hotchk155/synchole/docs/packing slip.pdf

Thank you for purchasing SYNCHOLE! I hope you find it useful and enjoy using it. For information please see http://six4pix.com/synchole
You can contact me with questions or feedback at sixtyfourpixels@gmail.com Cheers, Jason

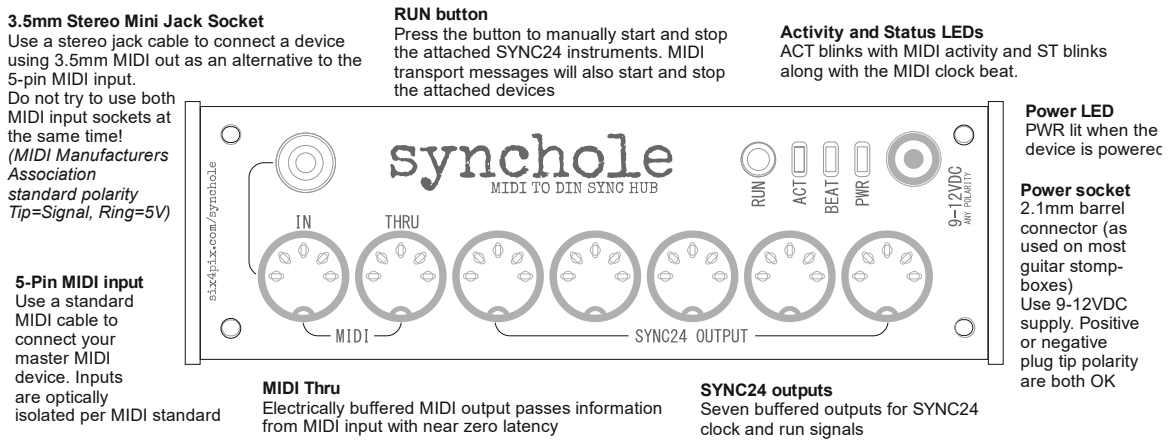
[picture p1: figure]
5-Pin MIDI input Use a standard MIDI cable to connect your master MIDI device. Inputs are optically isolated per MIDI standard; Power LED PWR lit when the device is powered; Activity and Status LEDs; along with the MIDI clock beat.; RUN button; the attached SYNC24 instruments. MIDI; the attached devices; Power socket 2.1mm barrel connector (as used on most guitar stomp- boxes) Use 9-12VDC supply. Positive or negative plug tip polarity are both OK MIDI Thru; from MIDI input with near zero latency; SYNC24 outputs Seven buffered outputs for SYNC24 clock and run signals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

ACT blinks with MIDI activity and ST blinks

Press the button to manually start and stop

transport messages will also start and stop

Electrically buffered MIDI output passes information

Use a stereo jack cable to connect a device using 3.5mm MIDI out as an alternative to the

Thank you for purchasing SYNCHOLE! I hope you find it useful and enjoy using it. For information please see http://six4pix.com/synchole
You can contact me with questions or feedback at sixtyfourpixels@gmail.com Cheers, Jason

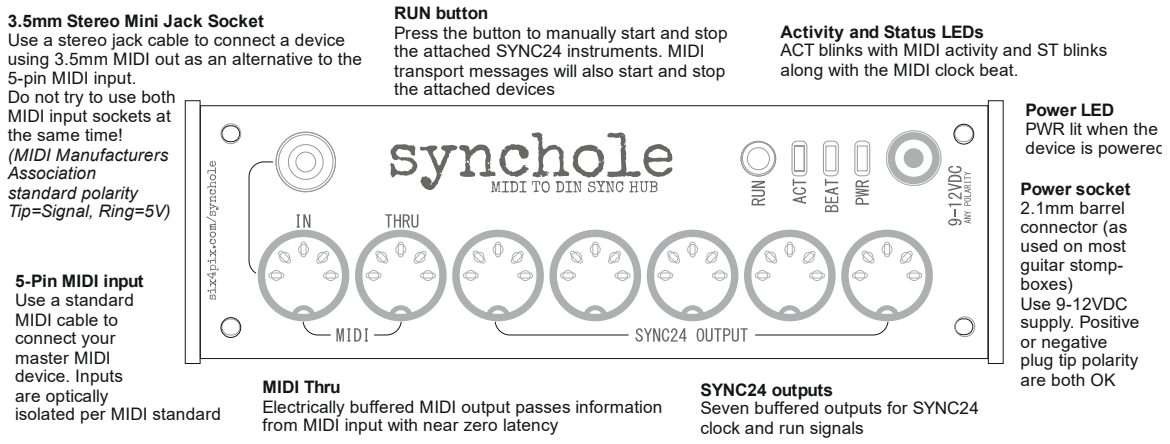
[picture p2: figure]
5-Pin MIDI input Use a standard MIDI cable to connect your master MIDI device. Inputs are optically isolated per MIDI standard; Power LED PWR lit when the device is powered; Activity and Status LEDs; along with the MIDI clock beat.; RUN button; the attached SYNC24 instruments. MIDI; the attached devices; Power socket 2.1mm barrel connector (as used on most guitar stomp- boxes) Use 9-12VDC supply. Positive or negative plug tip polarity are both OK MIDI Thru; from MIDI input with near zero latency; SYNC24 outputs Seven buffered outputs for SYNC24 clock and run signals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

ACT blinks with MIDI activity and ST blinks

Press the button to manually start and stop

transport messages will also start and stop

Electrically buffered MIDI output passes information

Use a stereo jack cable to connect a device using 3.5mm MIDI out as an alternative to the
