hotchk155/synchole/fascia/synchole-fascia-cuts.png

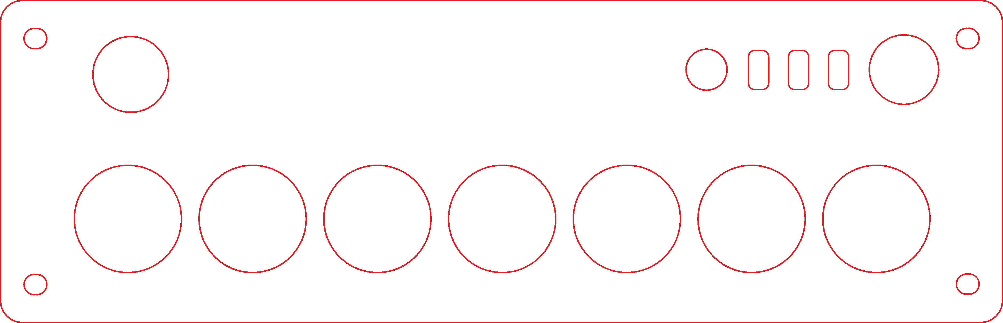
fascia/synchole-fascia-cuts.png
