hotchk155/synchole/fascia/synchole-fascia.png

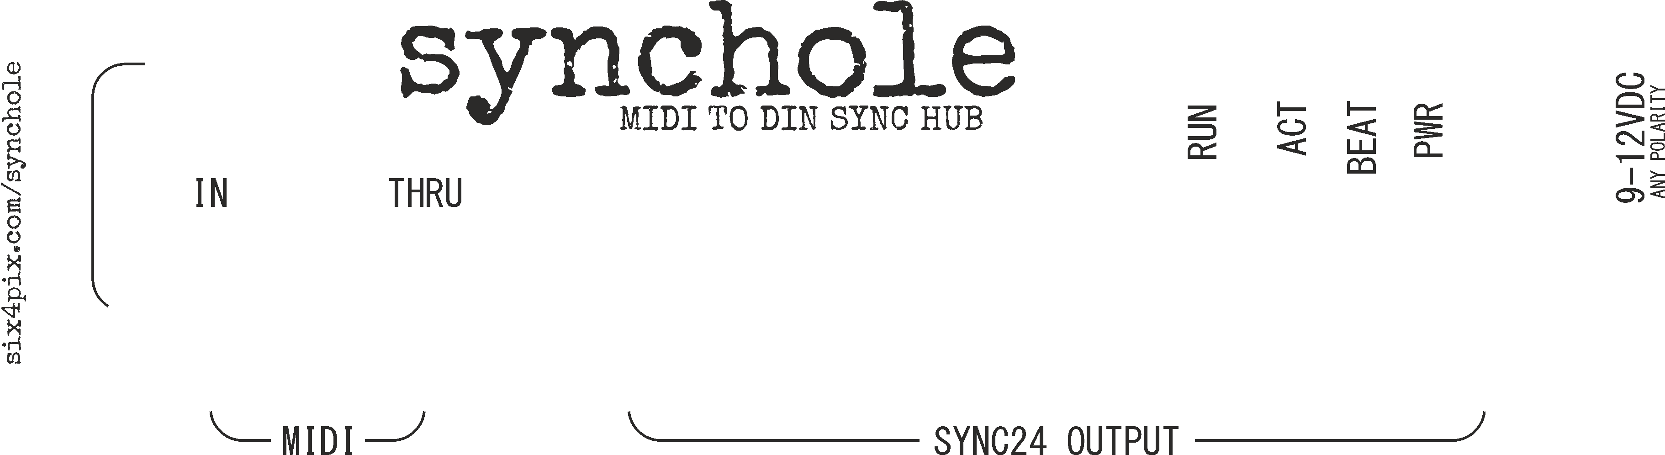
fascia/synchole-fascia.png
