hotchk155/synchole/hardware/synchole-bom.xlsx

Comment | Designator | Footprint | JLCPCB Part #（optional）
100nF | C1 | 0805
100nF | C2 | 0805
100nF | C3 | 0805
100nF | C4 | 0805
100nF | C5 | 0805
TS4148 | D1 | 0805
CD4050BD | IC1 | SO16
LD1117S50CTR | IC2 | SOT223
CD4050BD | IC3 | SO16
PIC12F1822-I/P | IC4 | SO08
1k | R1 | 0805
1k | R2 | 0805
1k | R3 | 0805
4.7k | R4 | 0805
1k | R5 | 0805
1k | R6 | 0805
1k | R7 | 0805
1k | R8 | 0805
1k | R9 | 0805
1k | R10 | 0805
1k | R11 | 0805
1k | R12 | 0805
1k | R13 | 0805
1k | R14 | 0805
220r | R15 | 0805
1.5k | R16 | 0805
1.5k | R17 | 0805
220r | R18 | 0805
220r | R19 | 0805
