hotchk155/synchole/fascia/synchole-fascia.dxf

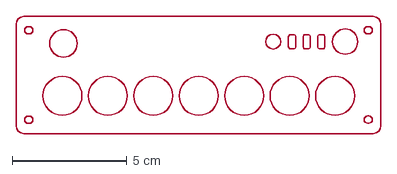
[picture p5: CAD file, 2025-12-12]
fascia/synchole-fascia.dxf
15.9 x 5.10 cm
