hotchk155/synchole/hardware/din-synch-hub.brd

## EAGLE design hardware/din-synch-hub.brd (2016-07-08)

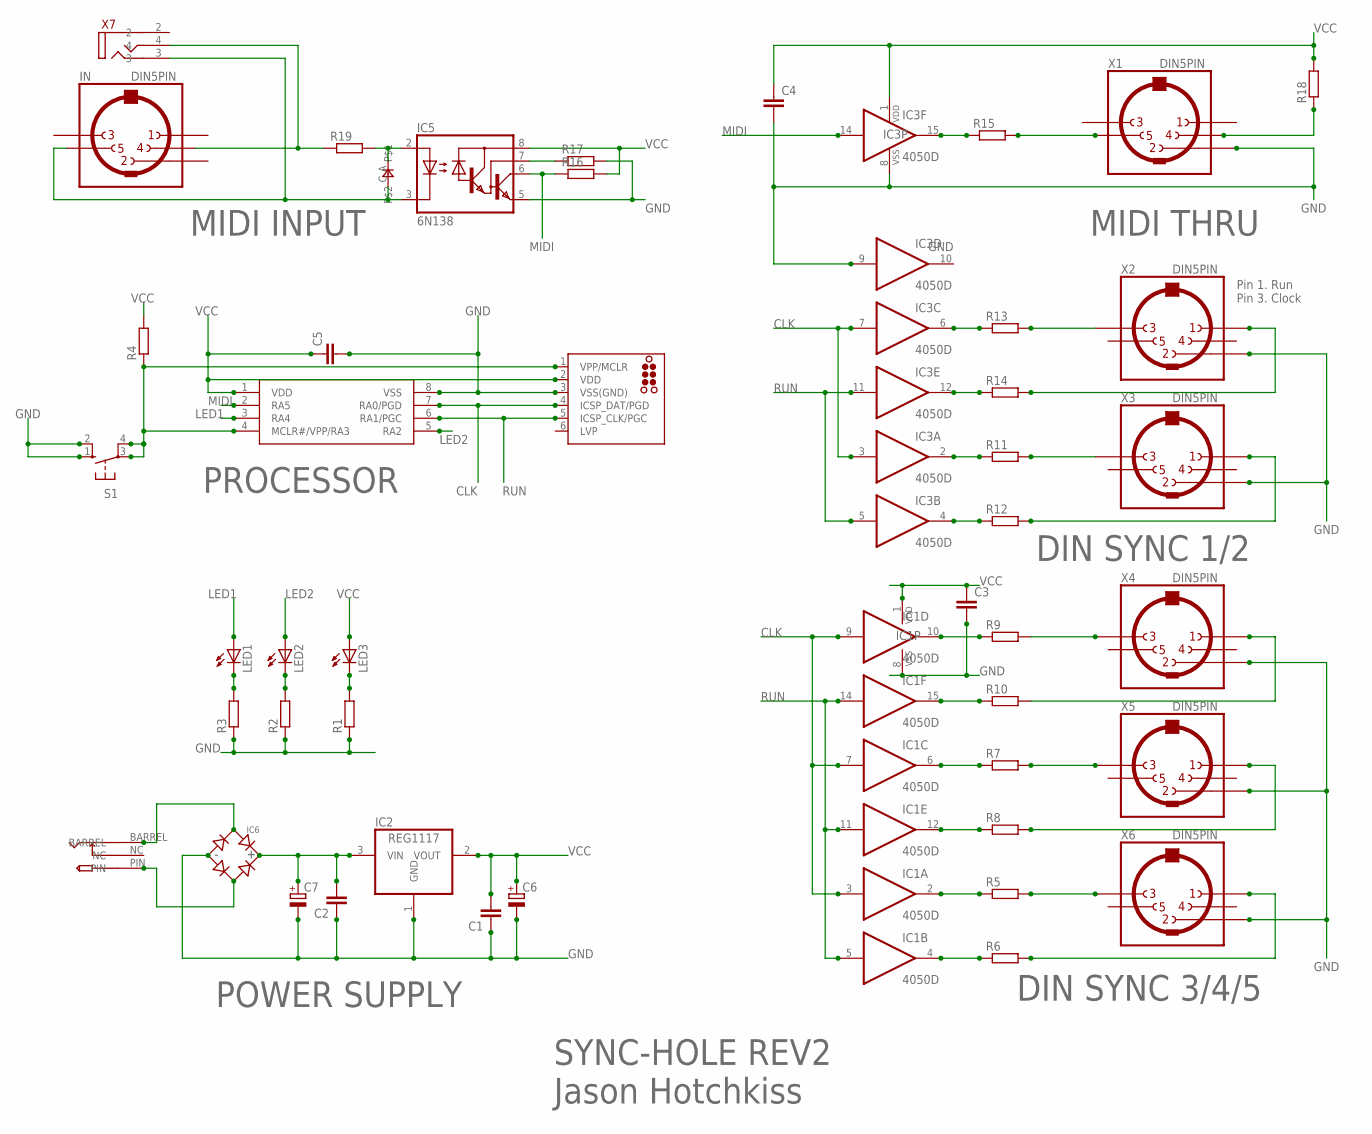
[picture p6: schematic din-synch-hub.sch]

Parts:
C1, C2, C3, C4, C5: C-EUC0805; C0805
C6, C7: CPOL-EUE2,5-6E; E2,5-6E
D1: 0805DIODE
IC1, IC3: 4050D; SO16
IC2: REG1117; SOT223
IC4: PIC12F1822SO08; SO08
IC5: 6N138; DIL08
IC6: BRIDGERECTIFIER; SOIC-4
ICSP: TC2030-MCP-NL
IN: DIN5PIN; EDGEDIN
LED1, LED2, LED3: LED3MM
R1, R2, R3, R4, R5, R6, R7, R8, R9, R10, R11, R12, R13, R14, R15, R16, R17, R18, R19: R-EU_R0805; R0805
S1: 10-XX; B3F-10XX
U$1: PWR_SOCKET_2_1MM
X1, X2, X3, X4, X5, X6: DIN5PIN; EDGEDIN
X7: VERTICAL_3_5MM_SOCKET

Connections:
CLK: IC1.3 (I), IC1.7 (I), IC1.9 (I), IC3.3 (I), IC3.7 (I), IC4.7 (RA0/PGD), ICSP.4 (ICSP_DAT/PGD)
GND: C1.1, C2.1, C3.2, C4.2, C5.2, C6.-, C7.-, IC1.8 (VSS), IC2.1 (GND), IC3.8 (VSS), IC3.9 (I), IC4.8 (VSS), IC5.5 (GND), IC6.-, ICSP.3 (VSS(GND)), R1.1, R2.1, R3.1, R17.2, S1.1 (S), S1.2 (S1), X1.2, X2.2, X3.2, X4.2, X5.2, X6.2
LED1: IC4.3 (RA4), LED1.A
LED2: IC4.5 (RA2), LED2.A
MIDI: IC3.14 (I), IC4.2 (RA5), IC5.6 (VO), R16.1
unnamed: IC3.15 (O), R15.1
unnamed: R15.2, X1.5
unnamed: IC3.6 (O), R13.1
unnamed: R18.1, X1.4
unnamed: IC3.12 (O), R14.1
unnamed: R13.2, X2.3
unnamed: IC3.4 (O), R12.1
unnamed: R14.2, X2.1
unnamed: IC3.2 (O), R11.1
unnamed: R11.2, X3.3
unnamed: R12.2, X3.1
unnamed: IC1.15 (O), R10.1
unnamed: IC1.12 (O), R8.1
unnamed: R9.2, X4.3
unnamed: IC1.10 (O), R9.1
unnamed: R10.2, X4.1
unnamed: IC1.2 (O), R5.1
unnamed: R7.2, X5.3
unnamed: IC1.4 (O), R6.1
unnamed: R8.2, X5.1
unnamed: IC1.6 (O), R7.1
unnamed: R5.2, X6.3
unnamed: R6.2, X6.1
unnamed: D1.C, IC5.3 (C), IN.5, X7.3
unnamed: IN.4, R19.1, X7.4
unnamed: D1.A, IC5.2 (A), R19.2
unnamed: LED3.K (C), R1.2
unnamed: IC5.7 (VB), R17.1
unnamed: IC4.4 (MCLR#/VPP/RA3), ICSP.1 (VPP/MCLR), R4.1, S1.3, S1.4 (P1)
unnamed: LED2.K (C), R2.2
unnamed: C2.2, C7.+, IC2.3 (VIN), IC6.+
unnamed: LED1.K (C), R3.2
unnamed: IC6.~2 (AC2), U$1.PIN
unnamed: IC6.~1 (AC1), U$1.BARREL
RUN: IC1.5 (I), IC1.11 (I), IC1.14 (I), IC3.5 (I), IC3.11 (I), IC4.6 (RA1/PGC), ICSP.5 (ICSP_CLK/PGC)
VCC: C1.2, C3.1, C4.1, C5.1, C6.+, IC1.1 (VDD), IC2.2 (VOUT), IC3.1 (VDD), IC4.1 (VDD), IC5.8 (VCC), ICSP.2 (VDD), LED3.A, R4.2, R16.2, R18.2

Notes on the sheet:
MIDI INPUT
PROCESSOR
POWER SUPPLY
MIDI THRU
DIN SYNC 1/2
DIN SYNC 3/4/5
SYNC-HOLE REV2
Jason Hotchkiss
Pin 1. Run Pin 3. Clock

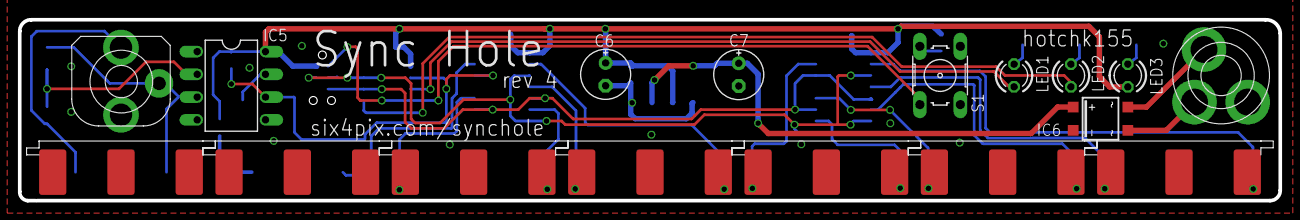
[picture p7: board din-synch-hub.brd from above]

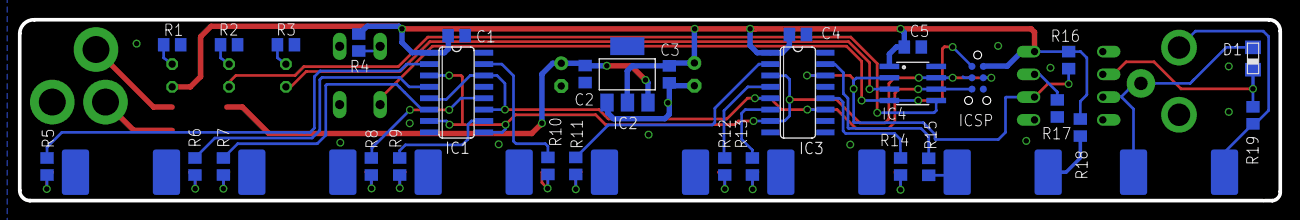
[picture p8: board din-synch-hub.brd from below]

Board: 2 copper layers, 140.7 x 20.2 mm, 47 parts (30 on the bottom side), 41 nets.
