hotchk155/synchole/(commit log)

2015-10-12 ready for fab
    [din-synch-hub.brd]
2016-02-05 case upodate
2016-02-14 case moved to new project
2016-02-14 v2 new PCB
    [din-synch-hub.sch]
2016-06-13 added new power socket
    [din-synch-hub.brd, din-synch-hub.sch]
2016-06-13 major changes
    [din-synch-hub.brd, din-synch-hub.sch]
2016-06-13 final tweak to rev3?
    [din-synch-hub.brd]
2016-06-13 fix bug
    [din-synch-hub.brd, din-synch-hub.sch]
2016-07-08 REV4
    moved leds to match bsplit
    [din-synch-hub.brd]
2016-07-08 move switch (rev4 pcb)
    [din-synch-hub.brd]
2025-12-12 PCB Fascia
    [synchole-fascia.dxf, synchole_fascia.kicad_pcb]
2026-01-13 production files
    [synchole-bom.xlsx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]
2026-01-13 kicad project for front panel
    [synchole_fascia.kicad_sch]
